sparkfunX/Qwiic_Spectral_Sensor-AS7341/Hardware/Qwiic_Spectral_Sensor_AS7341.pdf

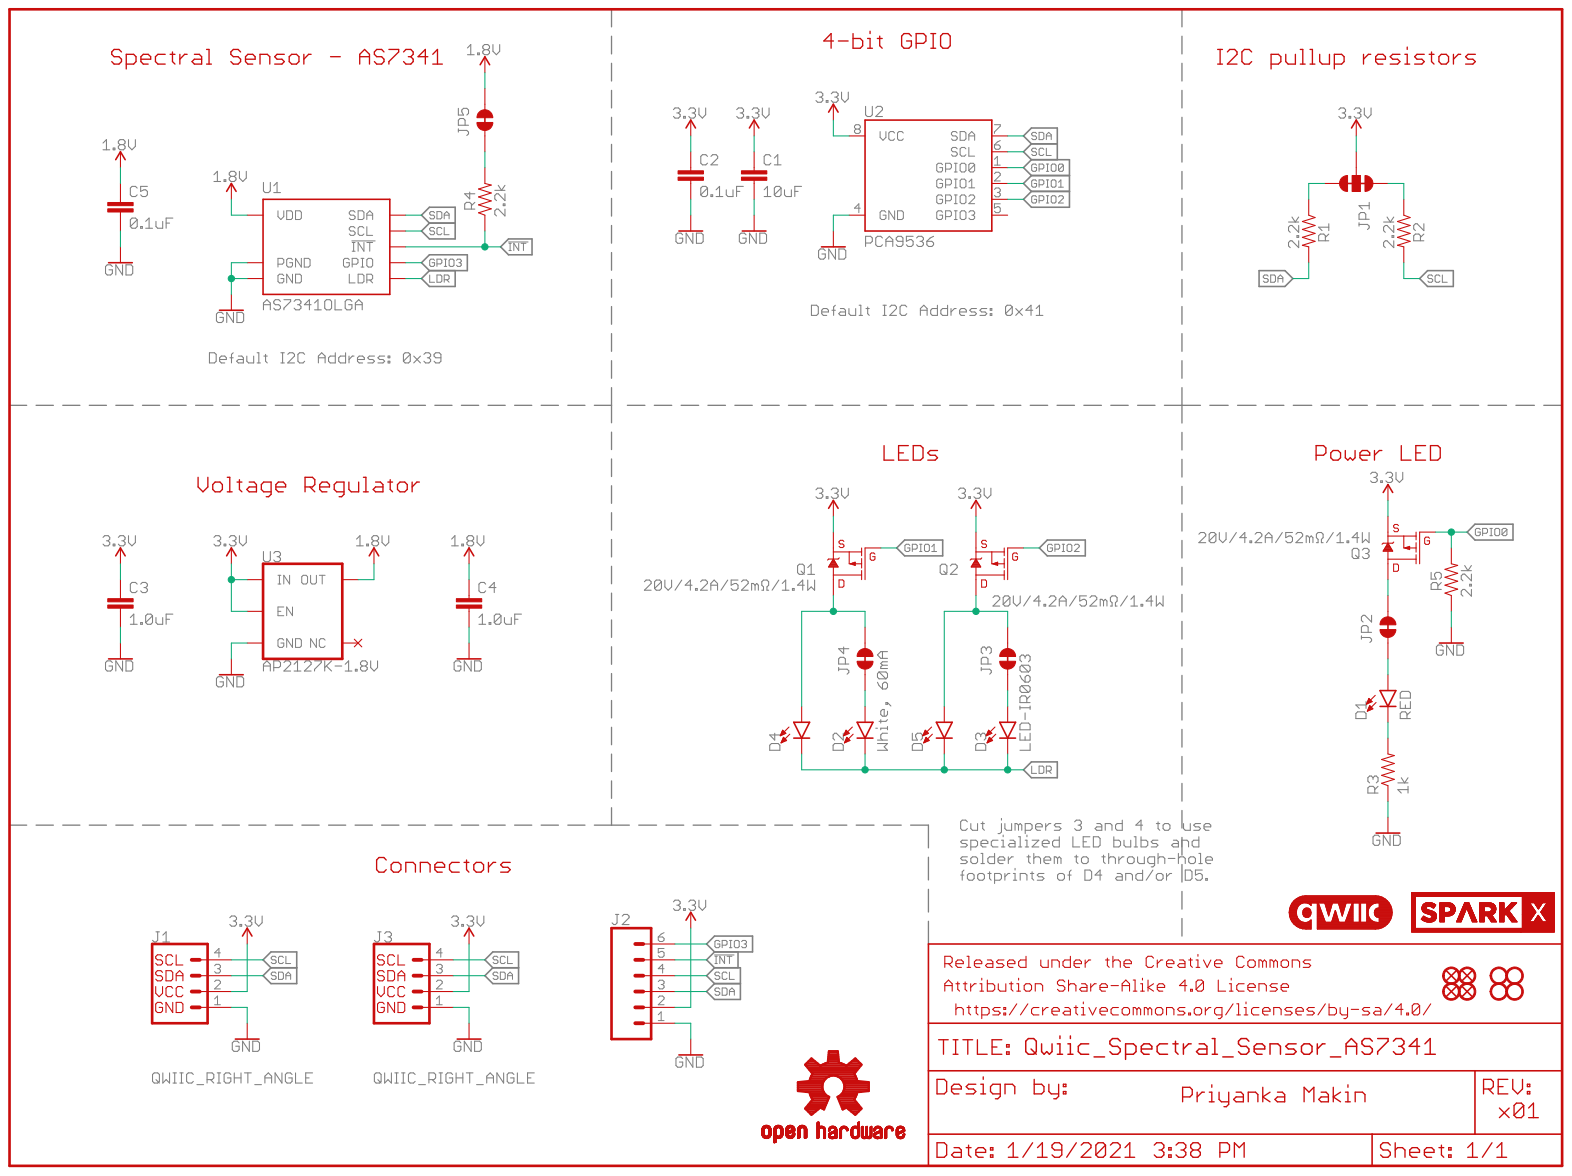
[picture p1: page 1]
