sparkfunX/Qwiic_Spectral_Sensor-AS7341/Hardware/Qwiic_Spectral_Sensor_AS7341.brd

## EAGLE design Hardware/Qwiic_Spectral_Sensor_AS7341.brd (2021-01-19)

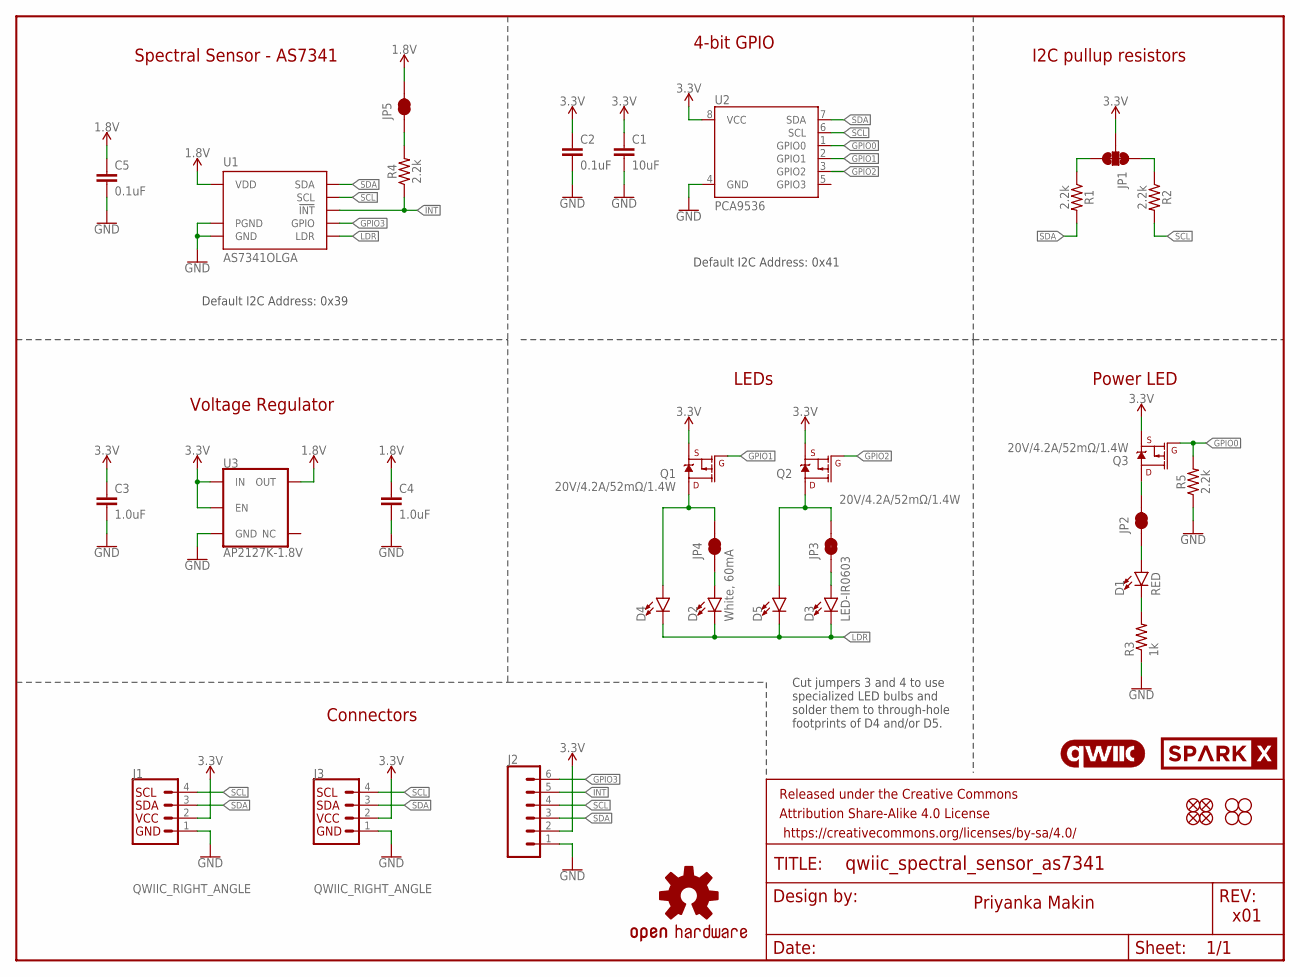
[picture p2: schematic Qwiic_Spectral_Sensor_AS7341.sch]

Parts:
C1: 10uF; 0603
C2, C5: 0.1uF; 0603
C3, C4: 1.0uF; 0603
D1: RED; LED-0603
D2: White, 60mA; SUPER_BRIGHT_SMD_LED_3014
D3: LED-IR0603; LED-0603
D4, D5: LED-3MM-NO_SILK; LED_3MM-NS
FD1, FD2, FD3, FD4: FIDUCIAL1X2; FIDUCIAL-1X2
FRAME1: FRAME-LETTER; CREATIVE_COMMONS
H1, H2, H3, H4: STAND-OFF
J1, J3: QWIIC_RIGHT_ANGLE; JST04_1MM_RA
J2: CONN_06NO_SILK_FEMALE_PTH; 1X06_NO_SILK
JP1: JUMPER-SMT_3_2-NC_TRACE_SILK; SMT-JUMPER_3_2-NC_TRACE_SILK
JP2, JP3, JP4, JP5: JUMPER-SMT_2_NC_TRACE_SILK; SMT-JUMPER_2_NC_TRACE_SILK
LOGO1: QWIIC_LOGO_6MM; QWIIC_6MM
Q1, Q2, Q3: 20V/4.2A/52mΩ/1.4W; SOT23-3
R1, R2, R4, R5: 2.2k; 0603
R3: 1k; 0603
U1: AS7341OLGA; OLGA8
U2: PCA9536; MSOP8
U3: AP2127K-1.8V; SOT23-5
U$1: OSHW-LOGOS; OSHW-LOGO-S
U$31: SPARKX-LOGO3; SPARKX-SMALL

Connections:
1.8V: C4.1, C5.1, JP5.2, U1.1 (VDD), U3.5 (OUT)
3.3V: C1.1, C2.1, C3.1, J1.2, J2.2, J3.2, JP1.2, Q1.2 (S), Q2.2 (S), Q3.2 (S), U2.8 (VCC), U3.1 (IN), U3.3 (EN)
!INT!: J2.5, R4.1, U1.7 (!INT!)
GND: C1.2, C2.2, C3.2, C4.2, C5.2, J1.1, J2.1, J3.1, R3.1, R5.1, U1.3 (GND), U1.5 (PGND), U2.4 (GND), U3.2 (GND)
GPIO0: Q3.1 (G), R5.2, U2.1 (GPIO0)
GPIO1: Q1.1 (G), U2.2 (GPIO1)
GPIO2: Q2.1 (G), U2.3 (GPIO2)
GPIO3: J2.6, U1.6 (GPIO)
LDR: D2.C, D3.C, D4.K (C), D5.K (C), U1.4 (LDR)
unnamed: JP1.3, R1.1
unnamed: D1.C, R3.2
unnamed: JP1.1, R2.1
unnamed: D1.A, JP2.1
unnamed: D2.A, JP4.1
unnamed: JP2.2, Q3.3 (D)
unnamed: D3.A, JP3.1
unnamed: D4.A, JP4.2, Q1.3 (D)
unnamed: D5.A, JP3.2, Q2.3 (D)
unnamed: JP5.1, R4.2
SCL: J1.4, J2.4, J3.4, R2.2, U1.2 (SCL), U2.6 (SCL)
SDA: J1.3, J2.3, J3.3, R1.2, U1.8 (SDA), U2.7 (SDA)

Notes on the sheet:
x01
Priyanka Makin
Connectors
Spectral Sensor - AS7341
4-bit GPIO
Power LED
Default I2C Address: 0x39
Default I2C Address: 0x41
I2C pullup resistors
Voltage Regulator
LEDs
Cut jumpers 3 and 4 to use specialized LED bulbs and solder them to through-hole footprints of D4 and/or D5.

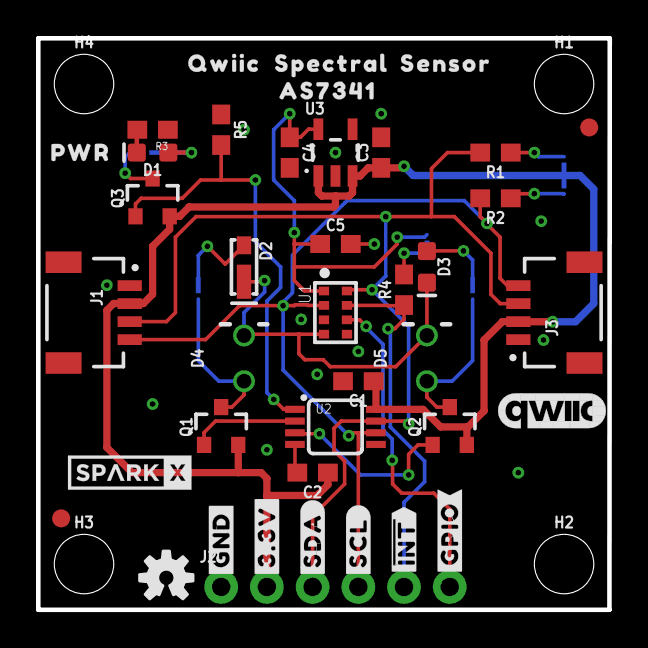
[picture p3: board Qwiic_Spectral_Sensor_AS7341.brd from above]

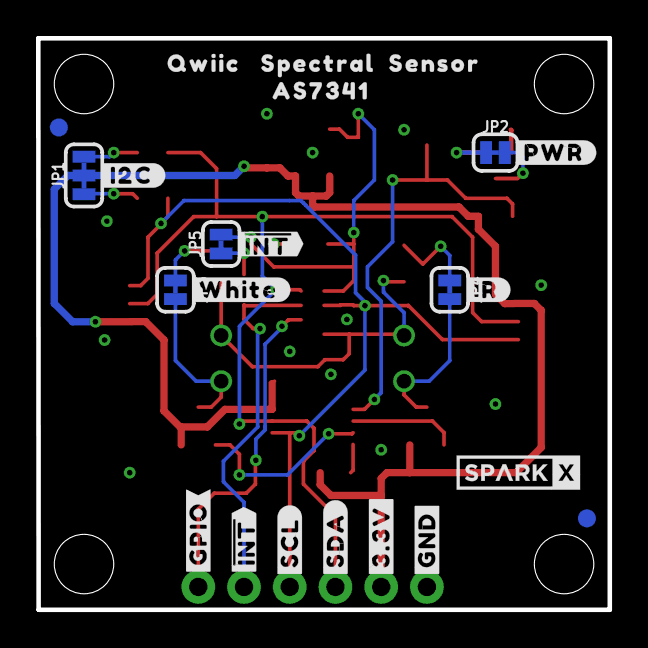
[picture p4: board Qwiic_Spectral_Sensor_AS7341.brd from below]

Board: 2 copper layers, 31.8 x 31.8 mm, 68 parts (23 on the bottom side), 21 nets.

Other parts of the board:
U$3, U$4: QWIIC0
U$5, U$8: SPECTRAL0
U$7: SPARKX-SMALL
U$9: #I2C#0
U$10: #PWR#0
U$11, U$21: SENSOR0
U$12: PWR0
U$13, U$14: #GND#0
U$15, U$16: #3#3V#0
U$17, U$18: #SDA#0
U$19, U$20: #SCL#0
U$22, U$23: AS73410
U$24, U$25, U$30: ##INT##0
U$26, U$27: #GPIO#0
U$28: #IR#0
U$29: #WHITE#0
