sparkfunX/Qwiic_Spectral_Sensor-AS7341/Hardware/Production/Qwiic_Spectral_Sensor_AS7341-Panel.brd

## EAGLE design Hardware/Production/Qwiic_Spectral_Sensor_AS7341-Panel.brd (2020-11-24)

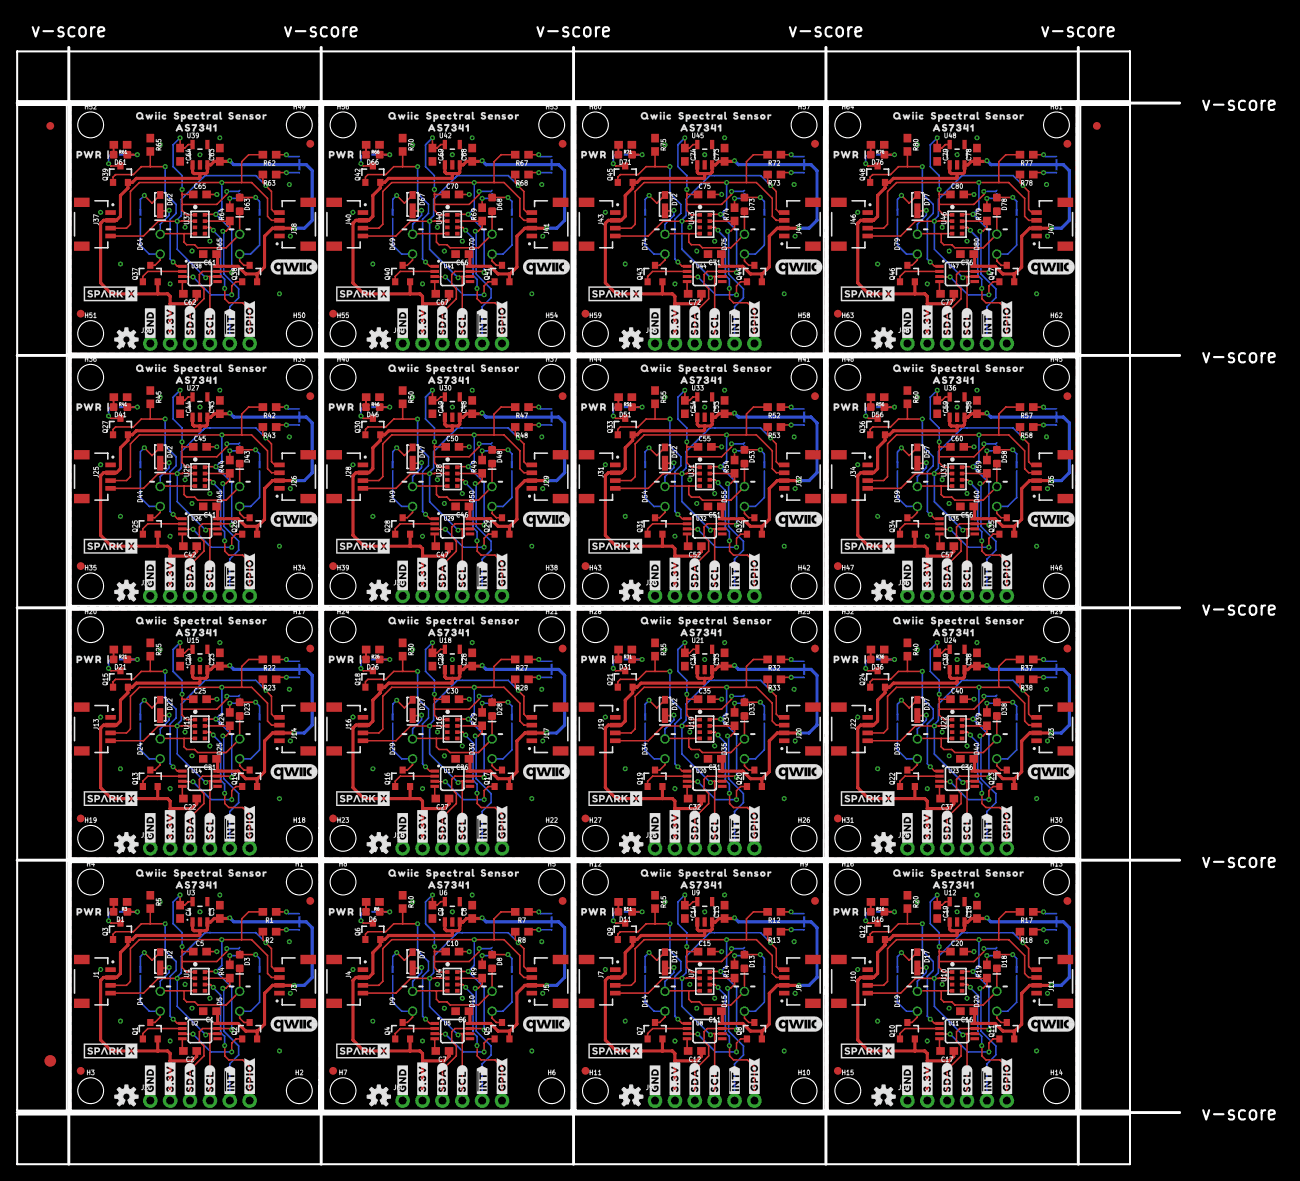
[picture p5: board Qwiic_Spectral_Sensor_AS7341-Panel.brd from above]

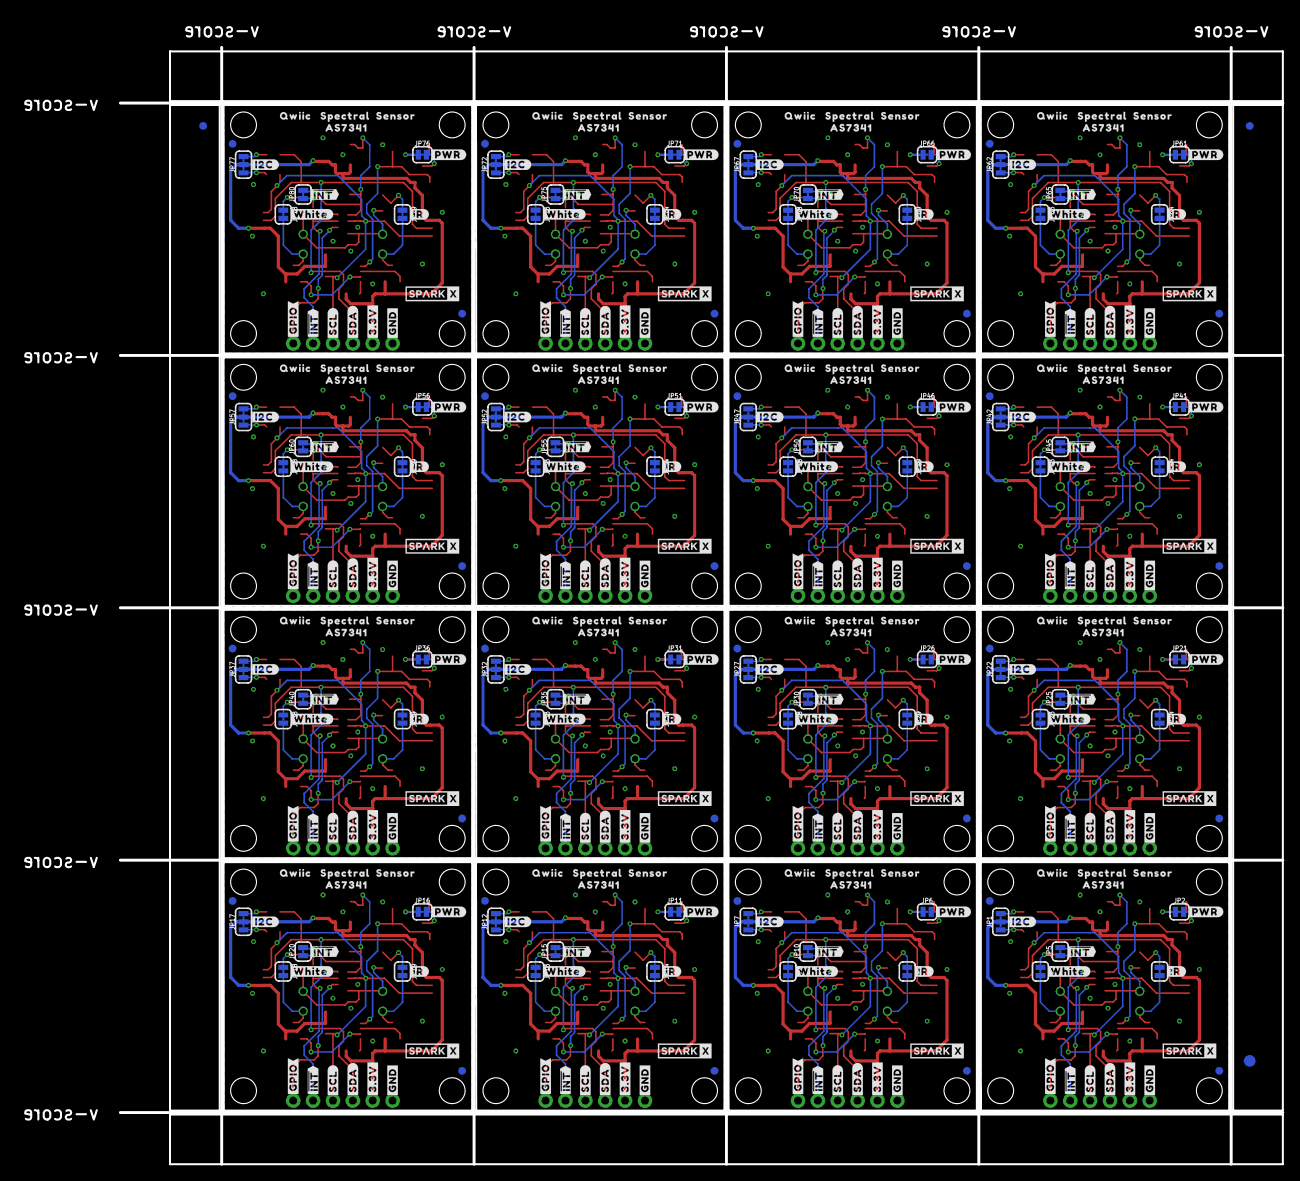
[picture p6: board Qwiic_Spectral_Sensor_AS7341-Panel.brd from below]

Board: 2 copper layers, 148.6 x 142.7 mm, 1078 parts (371 on the bottom side), 336 nets.

Parts:
C1, C6, C11, C16, C21, C26, C31, C36, C41, C46, C51, C56, C61, C66, C71, C76: 10uF; 0603
C2, C5, C7, C10, C12, C15, C17, C20, C22, C25, C27, C30, C32, C35, C37, C40, C42, C45, C47, C50, C52, C55, C57, C60, C62, C65, C67, C70, C72, C75, C77, C80: 0.1uF; 0603
C3, C4, C8, C9, C13, C14, C18, C19, C23, C24, C28, C29, C33, C34, C38, C39, C43, C44, C48, C49, C53, C54, C58, C59, C63, C64, C68, C69, C73, C74, C78, C79: 1.0uF; 0603
D1, D6, D11, D16, D21, D26, D31, D36, D41, D46, D51, D56, D61, D66, D71, D76: RED; LED-0603
D2, D7, D12, D17, D22, D27, D32, D37, D42, D47, D52, D57, D62, D67, D72, D77: White, 60mA; SUPER_BRIGHT_SMD_LED_3014
D3, D8, D13, D18, D23, D28, D33, D38, D43, D48, D53, D58, D63, D68, D73, D78: LED-IR0603; LED-0603
D4, D5, D9, D10, D14, D15, D19, D20, D24, D25, D29, D30, D34, D35, D39, D40, D44, D45, D49, D50, D54, D55, D59, D60, D64, D65, D69, D70, D74, D75, D79, D80: LED_3MM-NS
E$1, E$2, E$3, E$4: FIDUCIAL-1X2
E$5, E$6: FIDUCIAL-1.5X3
FD1, FD2, FD3, FD4, FD5, FD6, FD7, FD8, FD9, FD10, FD11, FD12, FD13, FD14, FD15, FD16, FD17, FD18, FD19, FD20, FD21, FD22, FD23, FD24, FD25, FD26, FD27, FD28, FD29, FD30, FD31, FD32, FD33, FD34, FD35, FD36, FD37, FD38, FD39, FD40, FD41, FD42, FD43, FD44, FD45, FD46, FD47, FD48, FD49, FD50, FD51, FD52, FD53, FD54, FD55, FD56, FD57, FD58, FD59, FD60, FD61, FD62, FD63, FD64: FIDUCIAL1X2; FIDUCIAL-1X2
H1, H2, H3, H4, H5, H6, H7, H8, H9, H10, H11, H12, H13, H14, H15, H16, H17, H18, H19, H20, H21, H22, H23, H24, H25, H26, H27, H28, H29, H30, H31, H32, H33, H34, H35, H36, H37, H38, H39, H40, H41, H42, H43, H44, H45, H46, H47, H48, H49, H50, H51, H52, H53, H54, H55, H56, H57, H58, H59, H60, H61, H62, H63, H64: STAND-OFF
J1, J3, J4, J5, J7, J8, J10, J11, J13, J14, J16, J17, J19, J20, J22, J23, J25, J26, J28, J29, J31, J32, J34, J35, J37, J38, J40, J41, J43, J44, J46, J47: QWIIC_RIGHT_ANGLE; JST04_1MM_RA
J2, J6, J9, J12, J15, J18, J21, J24, J27, J30, J33, J36, J39, J42, J45, J48: 1X06_NO_SILK
JP1, JP7, JP12, JP17, JP22, JP27, JP32, JP37, JP42, JP47, JP52, JP57, JP62, JP67, JP72, JP77: JUMPER-SMT_3_2-NC_TRACE_SILK; SMT-JUMPER_3_2-NC_TRACE_SILK
JP2, JP3, JP4, JP5, JP6, JP8, JP9, JP10, JP11, JP13, JP14, JP15, JP16, JP18, JP19, JP20, JP21, JP23, JP24, JP25, JP26, JP28, JP29, JP30, JP31, JP33, JP34, JP35, JP36, JP38, JP39, JP40, JP41, JP43, JP44, JP45, JP46, JP48, JP49, JP50, JP51, JP53, JP54, JP55, JP56, JP58, JP59, JP60, JP61, JP63, JP64, JP65, JP66, JP68, JP69, JP70, JP71, JP73, JP74, JP75, JP76, JP78, JP79, JP80: JUMPER-SMT_2_NC_TRACE_SILK; SMT-JUMPER_2_NC_TRACE_SILK
Q1, Q2, Q3, Q4, Q5, Q6, Q7, Q8, Q9, Q10, Q11, Q12, Q13, Q14, Q15, Q16, Q17, Q18, Q19, Q20, Q21, Q22, Q23, Q24, Q25, Q26, Q27, Q28, Q29, Q30, Q31, Q32, Q33, Q34, Q35, Q36, Q37, Q38, Q39, Q40, Q41, Q42, Q43, Q44, Q45, Q46, Q47, Q48: 20V/4.2A/52mΩ/1.4W; SOT23-3
R1, R2, R4, R5, R7, R8, R9, R10, R12, R13, R14, R15, R17, R18, R19, R20, R22, R23, R24, R25, R27, R28, R29, R30, R32, R33, R34, R35, R37, R38, R39, R40, R42, R43, R44, R45, R47, R48, R49, R50, R52, R53, R54, R55, R57, R58, R59, R60, R62, R63, R64, R65, R67, R68, R69, R70, R72, R73, R74, R75, R77, R78, R79, R80: 2.2k; 0603
R3, R6, R11, R16, R21, R26, R31, R36, R41, R46, R51, R56, R61, R66, R71, R76: 1k; 0603
U1, U4, U7, U10, U13, U16, U19, U22, U25, U28, U31, U34, U37, U40, U43, U46: AS7341OLGA; OLGA8
U2, U5, U8, U11, U14, U17, U20, U23, U26, U29, U32, U35, U38, U41, U44, U47: PCA9536; MSOP8
U3, U6, U9, U12, U15, U18, U21, U24, U27, U30, U33, U36, U39, U42, U45, U48: AP2127K-1.8V; SOT23-5
U$1, U$31, U$61, U$91, U$121, U$151, U$181, U$211, U$241, U$271, U$301, U$331, U$361, U$391, U$421, U$451: OSHW-LOGOS; OSHW-LOGO-S
U$2, U$32, U$62, U$92, U$122, U$152, U$182, U$212, U$242, U$272, U$302, U$332, U$362, U$392, U$422, U$452: QWIIC_6MM
U$3, U$4, U$46, U$47, U$76, U$77, U$106, U$107, U$136, U$137, U$166, U$167, U$196, U$197, U$226, U$227, U$256, U$257, U$286, U$287, U$316, U$317, U$346, U$347, U$376, U$377, U$406, U$407, U$436, U$437, U$466, U$467: QWIIC0
U$5, U$8, U$48, U$49, U$78, U$79, U$108, U$109, U$138, U$139, U$168, U$169, U$198, U$199, U$228, U$229, U$258, U$259, U$288, U$289, U$318, U$319, U$348, U$349, U$378, U$379, U$408, U$409, U$438, U$439, U$468, U$469: SPECTRAL0
U$6, U$7, U$44, U$45, U$74, U$75, U$104, U$105, U$134, U$135, U$164, U$165, U$194, U$195, U$224, U$225, U$254, U$255, U$284, U$285, U$314, U$315, U$344, U$345, U$374, U$375, U$404, U$405, U$434, U$435, U$464, U$465: SPARKX-SMALL
U$9, U$35, U$65, U$95, U$125, U$155, U$185, U$215, U$245, U$275, U$305, U$335, U$365, U$395, U$425, U$455: #I2C#0
U$10, U$34, U$64, U$94, U$124, U$154, U$184, U$214, U$244, U$274, U$304, U$334, U$364, U$394, U$424, U$454: #PWR#0
U$11, U$21, U$50, U$51, U$80, U$81, U$110, U$111, U$140, U$141, U$170, U$171, U$200, U$201, U$230, U$231, U$260, U$261, U$290, U$291, U$320, U$321, U$350, U$351, U$380, U$381, U$410, U$411, U$440, U$441, U$470, U$471: SENSOR0
U$12, U$33, U$63, U$93, U$123, U$153, U$183, U$213, U$243, U$273, U$303, U$333, U$363, U$393, U$423, U$453: PWR0
U$13, U$14, U$36, U$37, U$66, U$67, U$96, U$97, U$126, U$127, U$156, U$157, U$186, U$187, U$216, U$217, U$246, U$247, U$276, U$277, U$306, U$307, U$336, U$337, U$366, U$367, U$396, U$397, U$426, U$427, U$456, U$457: #GND#0
U$15, U$16, U$38, U$39, U$68, U$69, U$98, U$99, U$128, U$129, U$158, U$159, U$188, U$189, U$218, U$219, U$248, U$249, U$278, U$279, U$308, U$309, U$338, U$339, U$368, U$369, U$398, U$399, U$428, U$429, U$458, U$459: #3#3V#0
U$17, U$18, U$40, U$41, U$70, U$71, U$100, U$101, U$130, U$131, U$160, U$161, U$190, U$191, U$220, U$221, U$250, U$251, U$280, U$281, U$310, U$311, U$340, U$341, U$370, U$371, U$400, U$401, U$430, U$431, U$460, U$461: #SDA#0
U$19, U$20, U$42, U$43, U$72, U$73, U$102, U$103, U$132, U$133, U$162, U$163, U$192, U$193, U$222, U$223, U$252, U$253, U$282, U$283, U$312, U$313, U$342, U$343, U$372, U$373, U$402, U$403, U$432, U$433, U$462, U$463: #SCL#0
U$22, U$23, U$52, U$53, U$82, U$83, U$112, U$113, U$142, U$143, U$172, U$173, U$202, U$203, U$232, U$233, U$262, U$263, U$292, U$293, U$322, U$323, U$352, U$353, U$382, U$383, U$412, U$413, U$442, U$443, U$472, U$473: AS73410
U$24, U$25, U$30, U$56, U$57, U$58, U$86, U$87, U$88, U$116, U$117, U$118, U$146, U$147, U$148, U$176, U$177, U$178, U$206, U$207, U$208, U$236, U$237, U$238, U$266, U$267, U$268, U$296, U$297, U$298, U$326, U$327, U$328, U$356, U$357, U$358, U$386, U$387, U$388, U$416, U$417, U$418, U$446, U$447, U$448, U$476, U$477, U$478: ##INT##0
U$26, U$27, U$59, U$60, U$89, U$90, U$119, U$120, U$149, U$150, U$179, U$180, U$209, U$210, U$239, U$240, U$269, U$270, U$299, U$300, U$329, U$330, U$359, U$360, U$389, U$390, U$419, U$420, U$449, U$450, U$479, U$480: #GPIO#0
U$28, U$54, U$84, U$114, U$144, U$174, U$204, U$234, U$264, U$294, U$324, U$354, U$384, U$414, U$444, U$474: #IR#0
U$29, U$55, U$85, U$115, U$145, U$175, U$205, U$235, U$265, U$295, U$325, U$355, U$385, U$415, U$445, U$475: #WHITE#0

Connections:
1.8V: C4.1, C5.1, JP5.2, U1.1, U3.5
1.8V1: C9.1, C10.1, JP10.2, U4.1, U6.5
1.8V2: C14.1, C15.1, JP15.2, U7.1, U9.5
1.8V3: C19.1, C20.1, JP20.2, U10.1, U12.5
1.8V4: C24.1, C25.1, JP25.2, U13.1, U15.5
1.8V5: C29.1, C30.1, JP30.2, U16.1, U18.5
1.8V6: C34.1, C35.1, JP35.2, U19.1, U21.5
1.8V7: C39.1, C40.1, JP40.2, U22.1, U24.5
1.8V8: C44.1, C45.1, JP45.2, U25.1, U27.5
1.8V9: C49.1, C50.1, JP50.2, U28.1, U30.5
1.8V10: C54.1, C55.1, JP55.2, U31.1, U33.5
1.8V11: C59.1, C60.1, JP60.2, U34.1, U36.5
1.8V12: C64.1, C65.1, JP65.2, U37.1, U39.5
1.8V13: C69.1, C70.1, JP70.2, U40.1, U42.5
1.8V14: C74.1, C75.1, JP75.2, U43.1, U45.5
1.8V15: C79.1, C80.1, JP80.2, U46.1, U48.5
3.3V: C1.1, C2.1, C3.1, J1.2, J2.2, J3.2, JP1.2, Q1.2, Q2.2, Q3.2, U2.8, U3.1, U3.3
3.3V1: C6.1, C7.1, C8.1, J4.2, J5.2, J6.2, JP7.2, Q4.2, Q5.2, Q6.2, U5.8, U6.1, U6.3
3.3V2: C11.1, C12.1, C13.1, J7.2, J8.2, J9.2, JP12.2, Q7.2, Q8.2, Q9.2, U8.8, U9.1, U9.3
3.3V3: C16.1, C17.1, C18.1, J10.2, J11.2, J12.2, JP17.2, Q10.2, Q11.2, Q12.2, U11.8, U12.1, U12.3
3.3V4: C21.1, C22.1, C23.1, J13.2, J14.2, J15.2, JP22.2, Q13.2, Q14.2, Q15.2, U14.8, U15.1, U15.3
3.3V5: C26.1, C27.1, C28.1, J16.2, J17.2, J18.2, JP27.2, Q16.2, Q17.2, Q18.2, U17.8, U18.1, U18.3
3.3V6: C31.1, C32.1, C33.1, J19.2, J20.2, J21.2, JP32.2, Q19.2, Q20.2, Q21.2, U20.8, U21.1, U21.3
3.3V7: C36.1, C37.1, C38.1, J22.2, J23.2, J24.2, JP37.2, Q22.2, Q23.2, Q24.2, U23.8, U24.1, U24.3
3.3V8: C41.1, C42.1, C43.1, J25.2, J26.2, J27.2, JP42.2, Q25.2, Q26.2, Q27.2, U26.8, U27.1, U27.3
3.3V9: C46.1, C47.1, C48.1, J28.2, J29.2, J30.2, JP47.2, Q28.2, Q29.2, Q30.2, U29.8, U30.1, U30.3
3.3V10: C51.1, C52.1, C53.1, J31.2, J32.2, J33.2, JP52.2, Q31.2, Q32.2, Q33.2, U32.8, U33.1, U33.3
3.3V11: C56.1, C57.1, C58.1, J34.2, J35.2, J36.2, JP57.2, Q34.2, Q35.2, Q36.2, U35.8, U36.1, U36.3
3.3V12: C61.1, C62.1, C63.1, J37.2, J38.2, J39.2, JP62.2, Q37.2, Q38.2, Q39.2, U38.8, U39.1, U39.3
3.3V13: C66.1, C67.1, C68.1, J40.2, J41.2, J42.2, JP67.2, Q40.2, Q41.2, Q42.2, U41.8, U42.1, U42.3
3.3V14: C71.1, C72.1, C73.1, J43.2, J44.2, J45.2, JP72.2, Q43.2, Q44.2, Q45.2, U44.8, U45.1, U45.3
3.3V15: C76.1, C77.1, C78.1, J46.2, J47.2, J48.2, JP77.2, Q46.2, Q47.2, Q48.2, U47.8, U48.1, U48.3
!INT!: J2.5, R4.1, U1.7
!INT!1: J6.5, R9.1, U4.7
!INT!2: J9.5, R14.1, U7.7
!INT!3: J12.5, R19.1, U10.7
!INT!4: J15.5, R24.1, U13.7
!INT!5: J18.5, R29.1, U16.7
!INT!6: J21.5, R34.1, U19.7
!INT!7: J24.5, R39.1, U22.7
!INT!8: J27.5, R44.1, U25.7
!INT!9: J30.5, R49.1, U28.7
!INT!10: J33.5, R54.1, U31.7
!INT!11: J36.5, R59.1, U34.7
!INT!12: J39.5, R64.1, U37.7
!INT!13: J42.5, R69.1, U40.7
!INT!14: J45.5, R74.1, U43.7
!INT!15: J48.5, R79.1, U46.7
GND: C1.2, C2.2, C3.2, C4.2, C5.2, J1.1, J2.1, J3.1, R3.1, R5.1, U1.3, U1.5, U2.4, U3.2
GND1: C6.2, C7.2, C8.2, C9.2, C10.2, J4.1, J5.1, J6.1, R6.1, R10.1, U4.3, U4.5, U5.4, U6.2
GND2: C11.2, C12.2, C13.2, C14.2, C15.2, J7.1, J8.1, J9.1, R11.1, R15.1, U7.3, U7.5, U8.4, U9.2
GND3: C16.2, C17.2, C18.2, C19.2, C20.2, J10.1, J11.1, J12.1, R16.1, R20.1, U10.3, U10.5, U11.4, U12.2
GND4: C21.2, C22.2, C23.2, C24.2, C25.2, J13.1, J14.1, J15.1, R21.1, R25.1, U13.3, U13.5, U14.4, U15.2
GND5: C26.2, C27.2, C28.2, C29.2, C30.2, J16.1, J17.1, J18.1, R26.1, R30.1, U16.3, U16.5, U17.4, U18.2
GND6: C31.2, C32.2, C33.2, C34.2, C35.2, J19.1, J20.1, J21.1, R31.1, R35.1, U19.3, U19.5, U20.4, U21.2
GND7: C36.2, C37.2, C38.2, C39.2, C40.2, J22.1, J23.1, J24.1, R36.1, R40.1, U22.3, U22.5, U23.4, U24.2
GND8: C41.2, C42.2, C43.2, C44.2, C45.2, J25.1, J26.1, J27.1, R41.1, R45.1, U25.3, U25.5, U26.4, U27.2
GND9: C46.2, C47.2, C48.2, C49.2, C50.2, J28.1, J29.1, J30.1, R46.1, R50.1, U28.3, U28.5, U29.4, U30.2
GND10: C51.2, C52.2, C53.2, C54.2, C55.2, J31.1, J32.1, J33.1, R51.1, R55.1, U31.3, U31.5, U32.4, U33.2
GND11: C56.2, C57.2, C58.2, C59.2, C60.2, J34.1, J35.1, J36.1, R56.1, R60.1, U34.3, U34.5, U35.4, U36.2
GND12: C61.2, C62.2, C63.2, C64.2, C65.2, J37.1, J38.1, J39.1, R61.1, R65.1, U37.3, U37.5, U38.4, U39.2
GND13: C66.2, C67.2, C68.2, C69.2, C70.2, J40.1, J41.1, J42.1, R66.1, R70.1, U40.3, U40.5, U41.4, U42.2
GND14: C71.2, C72.2, C73.2, C74.2, C75.2, J43.1, J44.1, J45.1, R71.1, R75.1, U43.3, U43.5, U44.4, U45.2
GND15: C76.2, C77.2, C78.2, C79.2, C80.2, J46.1, J47.1, J48.1, R76.1, R80.1, U46.3, U46.5, U47.4, U48.2
GPIO0: Q3.1, R5.2, U2.1
GPIO1: Q1.1, U2.2
GPIO2: Q2.1, U2.3
GPIO3: J2.6, U1.6
GPIO4: Q6.1, R10.2, U5.1
GPIO5: Q4.1, U5.2
GPIO6: Q5.1, U5.3
GPIO7: J6.6, U4.6
GPIO8: Q9.1, R15.2, U8.1
GPIO9: Q7.1, U8.2
GPIO10: Q8.1, U8.3
GPIO11: J9.6, U7.6
GPIO12: Q12.1, R20.2, U11.1
GPIO13: Q10.1, U11.2
GPIO14: Q11.1, U11.3
GPIO15: J12.6, U10.6
GPIO16: Q15.1, R25.2, U14.1
GPIO17: Q13.1, U14.2
GPIO18: Q14.1, U14.3
GPIO19: J15.6, U13.6
GPIO20: Q18.1, R30.2, U17.1
GPIO21: Q16.1, U17.2
GPIO22: Q17.1, U17.3
GPIO23: J18.6, U16.6
GPIO24: Q21.1, R35.2, U20.1
GPIO25: Q19.1, U20.2
GPIO26: Q20.1, U20.3
GPIO27: J21.6, U19.6
GPIO28: Q24.1, R40.2, U23.1
GPIO29: Q22.1, U23.2
GPIO30: Q23.1, U23.3
GPIO31: J24.6, U22.6
GPIO32: Q27.1, R45.2, U26.1
GPIO33: Q25.1, U26.2
GPIO34: Q26.1, U26.3
GPIO35: J27.6, U25.6
GPIO36: Q30.1, R50.2, U29.1
GPIO37: Q28.1, U29.2
GPIO38: Q29.1, U29.3
GPIO39: J30.6, U28.6
GPIO40: Q33.1, R55.2, U32.1
GPIO41: Q31.1, U32.2
GPIO42: Q32.1, U32.3
GPIO43: J33.6, U31.6
GPIO44: Q36.1, R60.2, U35.1
GPIO45: Q34.1, U35.2
GPIO46: Q35.1, U35.3
GPIO47: J36.6, U34.6
GPIO48: Q39.1, R65.2, U38.1
GPIO49: Q37.1, U38.2
GPIO50: Q38.1, U38.3
GPIO51: J39.6, U37.6
GPIO52: Q42.1, R70.2, U41.1
GPIO53: Q40.1, U41.2
GPIO54: Q41.1, U41.3
GPIO55: J42.6, U40.6
GPIO56: Q45.1, R75.2, U44.1
GPIO57: Q43.1, U44.2
GPIO58: Q44.1, U44.3
GPIO59: J45.6, U43.6
GPIO60: Q48.1, R80.2, U47.1
GPIO61: Q46.1, U47.2
GPIO62: Q47.1, U47.3
GPIO63: J48.6, U46.6
LDR: D2.C, D3.C, D4.K, D5.K, U1.4
LDR1: D7.C, D8.C, D9.K, D10.K, U4.4
LDR2: D12.C, D13.C, D14.K, D15.K, U7.4
LDR3: D17.C, D18.C, D19.K, D20.K, U10.4
LDR4: D22.C, D23.C, D24.K, D25.K, U13.4
LDR5: D27.C, D28.C, D29.K, D30.K, U16.4
LDR6: D32.C, D33.C, D34.K, D35.K, U19.4
LDR7: D37.C, D38.C, D39.K, D40.K, U22.4
LDR8: D42.C, D43.C, D44.K, D45.K, U25.4
LDR9: D47.C, D48.C, D49.K, D50.K, U28.4
LDR10: D52.C, D53.C, D54.K, D55.K, U31.4
LDR11: D57.C, D58.C, D59.K, D60.K, U34.4
LDR12: D62.C, D63.C, D64.K, D65.K, U37.4
LDR13: D67.C, D68.C, D69.K, D70.K, U40.4
LDR14: D72.C, D73.C, D74.K, D75.K, U43.4
LDR15: D77.C, D78.C, D79.K, D80.K, U46.4
unnamed: JP1.3, R1.1
unnamed: D1.C, R3.2
unnamed: JP1.1, R2.1
unnamed: D1.A, JP2.1
unnamed: D2.A, JP4.1
unnamed: JP2.2, Q3.3
unnamed: D3.A, JP3.1
unnamed: D4.A, JP4.2, Q1.3
unnamed: D5.A, JP3.2, Q2.3
unnamed: JP5.1, R4.2
unnamed: D6.C, R6.2
unnamed: D6.A, JP6.1
unnamed: JP7.3, R7.1
unnamed: JP7.1, R8.1
unnamed: D7.A, JP9.1
unnamed: D8.A, JP8.1
unnamed: D9.A, JP9.2, Q4.3
unnamed: D10.A, JP8.2, Q5.3
unnamed: JP6.2, Q6.3
unnamed: JP10.1, R9.2
unnamed: D11.C, R11.2
unnamed: D11.A, JP11.1
unnamed: JP12.3, R12.1
unnamed: JP12.1, R13.1
unnamed: D12.A, JP14.1
unnamed: D13.A, JP13.1
unnamed: D14.A, JP14.2, Q7.3
unnamed: D15.A, JP13.2, Q8.3
unnamed: JP11.2, Q9.3
unnamed: JP15.1, R14.2
unnamed: D16.C, R16.2
unnamed: D16.A, JP16.1
unnamed: JP17.3, R17.1
unnamed: JP17.1, R18.1
unnamed: D17.A, JP19.1
unnamed: D18.A, JP18.1
unnamed: D19.A, JP19.2, Q10.3
unnamed: D20.A, JP18.2, Q11.3
unnamed: JP16.2, Q12.3
unnamed: JP20.1, R19.2
unnamed: D21.C, R21.2
unnamed: D21.A, JP21.1
unnamed: JP22.3, R22.1
unnamed: JP22.1, R23.1
unnamed: D22.A, JP24.1
unnamed: D23.A, JP23.1
unnamed: D24.A, JP24.2, Q13.3
unnamed: D25.A, JP23.2, Q14.3
unnamed: JP21.2, Q15.3
unnamed: JP25.1, R24.2
unnamed: D26.C, R26.2
unnamed: D26.A, JP26.1
unnamed: JP27.3, R27.1
unnamed: JP27.1, R28.1
unnamed: D27.A, JP29.1
unnamed: D28.A, JP28.1
unnamed: D29.A, JP29.2, Q16.3
unnamed: D30.A, JP28.2, Q17.3
unnamed: JP26.2, Q18.3
unnamed: JP30.1, R29.2
unnamed: D31.C, R31.2
unnamed: D31.A, JP31.1
unnamed: JP32.3, R32.1
unnamed: JP32.1, R33.1
unnamed: D32.A, JP34.1
unnamed: D33.A, JP33.1
unnamed: D34.A, JP34.2, Q19.3
unnamed: D35.A, JP33.2, Q20.3
unnamed: JP31.2, Q21.3
unnamed: JP35.1, R34.2
unnamed: D36.C, R36.2
unnamed: D36.A, JP36.1
unnamed: JP37.3, R37.1
unnamed: JP37.1, R38.1
unnamed: D37.A, JP39.1
unnamed: D38.A, JP38.1
unnamed: D39.A, JP39.2, Q22.3
unnamed: D40.A, JP38.2, Q23.3
unnamed: JP36.2, Q24.3
unnamed: JP40.1, R39.2
unnamed: D41.C, R41.2
unnamed: D41.A, JP41.1
unnamed: JP42.3, R42.1
unnamed: JP42.1, R43.1
unnamed: D42.A, JP44.1
unnamed: D43.A, JP43.1
unnamed: D44.A, JP44.2, Q25.3
unnamed: D45.A, JP43.2, Q26.3
unnamed: JP41.2, Q27.3
unnamed: JP45.1, R44.2
unnamed: D46.C, R46.2
unnamed: D46.A, JP46.1
unnamed: JP47.3, R47.1
unnamed: JP47.1, R48.1
unnamed: D47.A, JP49.1
unnamed: D48.A, JP48.1
unnamed: D49.A, JP49.2, Q28.3
unnamed: D50.A, JP48.2, Q29.3
unnamed: JP46.2, Q30.3
unnamed: JP50.1, R49.2
unnamed: D51.C, R51.2
unnamed: D51.A, JP51.1
unnamed: JP52.3, R52.1
unnamed: JP52.1, R53.1
unnamed: D52.A, JP54.1
unnamed: D53.A, JP53.1
unnamed: D54.A, JP54.2, Q31.3
unnamed: D55.A, JP53.2, Q32.3
unnamed: JP51.2, Q33.3
unnamed: JP55.1, R54.2
unnamed: D56.C, R56.2
unnamed: D56.A, JP56.1
unnamed: JP57.3, R57.1
unnamed: JP57.1, R58.1
unnamed: D57.A, JP59.1
unnamed: D58.A, JP58.1
unnamed: D59.A, JP59.2, Q34.3
unnamed: D60.A, JP58.2, Q35.3
unnamed: JP56.2, Q36.3
unnamed: JP60.1, R59.2
unnamed: D61.C, R61.2
unnamed: D61.A, JP61.1
unnamed: JP62.3, R62.1
unnamed: JP62.1, R63.1
unnamed: D62.A, JP64.1
unnamed: D63.A, JP63.1
unnamed: D64.A, JP64.2, Q37.3
unnamed: D65.A, JP63.2, Q38.3
unnamed: JP61.2, Q39.3
unnamed: JP65.1, R64.2
unnamed: D66.C, R66.2
unnamed: D66.A, JP66.1
unnamed: JP67.3, R67.1
unnamed: JP67.1, R68.1
unnamed: D67.A, JP69.1
unnamed: D68.A, JP68.1
unnamed: D69.A, JP69.2, Q40.3
unnamed: D70.A, JP68.2, Q41.3
unnamed: JP66.2, Q42.3
unnamed: JP70.1, R69.2
unnamed: D71.C, R71.2
unnamed: D71.A, JP71.1
unnamed: JP72.3, R72.1
unnamed: JP72.1, R73.1
unnamed: D72.A, JP74.1
unnamed: D73.A, JP73.1
unnamed: D74.A, JP74.2, Q43.3
unnamed: D75.A, JP73.2, Q44.3
unnamed: JP71.2, Q45.3
unnamed: JP75.1, R74.2
unnamed: D76.C, R76.2
unnamed: D76.A, JP76.1
unnamed: JP77.3, R77.1
unnamed: JP77.1, R78.1
unnamed: D77.A, JP79.1
unnamed: D78.A, JP78.1
unnamed: D79.A, JP79.2, Q46.3
unnamed: D80.A, JP78.2, Q47.3
unnamed: JP76.2, Q48.3
unnamed: JP80.1, R79.2
SCL: J1.4, J2.4, J3.4, R2.2, U1.2, U2.6
SCL1: J4.4, J5.4, J6.4, R8.2, U4.2, U5.6
SCL2: J7.4, J8.4, J9.4, R13.2, U7.2, U8.6
SCL3: J10.4, J11.4, J12.4, R18.2, U10.2, U11.6
SCL4: J13.4, J14.4, J15.4, R23.2, U13.2, U14.6
SCL5: J16.4, J17.4, J18.4, R28.2, U16.2, U17.6
SCL6: J19.4, J20.4, J21.4, R33.2, U19.2, U20.6
SCL7: J22.4, J23.4, J24.4, R38.2, U22.2, U23.6
SCL8: J25.4, J26.4, J27.4, R43.2, U25.2, U26.6
SCL9: J28.4, J29.4, J30.4, R48.2, U28.2, U29.6
SCL10: J31.4, J32.4, J33.4, R53.2, U31.2, U32.6
SCL11: J34.4, J35.4, J36.4, R58.2, U34.2, U35.6
SCL12: J37.4, J38.4, J39.4, R63.2, U37.2, U38.6
SCL13: J40.4, J41.4, J42.4, R68.2, U40.2, U41.6
SCL14: J43.4, J44.4, J45.4, R73.2, U43.2, U44.6
SCL15: J46.4, J47.4, J48.4, R78.2, U46.2, U47.6
SDA: J1.3, J2.3, J3.3, R1.2, U1.8, U2.7
SDA1: J4.3, J5.3, J6.3, R7.2, U4.8, U5.7
SDA2: J7.3, J8.3, J9.3, R12.2, U7.8, U8.7
SDA3: J10.3, J11.3, J12.3, R17.2, U10.8, U11.7
SDA4: J13.3, J14.3, J15.3, R22.2, U13.8, U14.7
SDA5: J16.3, J17.3, J18.3, R27.2, U16.8, U17.7
SDA6: J19.3, J20.3, J21.3, R32.2, U19.8, U20.7
SDA7: J22.3, J23.3, J24.3, R37.2, U22.8, U23.7
SDA8: J25.3, J26.3, J27.3, R42.2, U25.8, U26.7
SDA9: J28.3, J29.3, J30.3, R47.2, U28.8, U29.7
SDA10: J31.3, J32.3, J33.3, R52.2, U31.8, U32.7
SDA11: J34.3, J35.3, J36.3, R57.2, U34.8, U35.7
SDA12: J37.3, J38.3, J39.3, R62.2, U37.8, U38.7
SDA13: J40.3, J41.3, J42.3, R67.2, U40.8, U41.7
SDA14: J43.3, J44.3, J45.3, R72.2, U43.8, U44.7
SDA15: J46.3, J47.3, J48.3, R77.2, U46.8, U47.7
