sparkfunX/Qwiic_Spectral_Sensor-AS7341/Hardware/Production/ordering_instructions.txt

panel size, 143x143mm
PCB thickness, 1.6mm
number of layers, 2
soldermask color, Black
silkscreen color, White
oz copper, 1oz
finish, HASL lead free
stencils, top
pcs per panel, 16
min trace width, 0.2032mm / 0.0080in
min drill size, 0.3048mm / 0.0120in
