sparkfunX/Qwiic_Spectral_Sensor-AS7341/(commit log)

2020-11-19 Initial commit
    Getting files in place
    [Qwiic_Spectral_Sensor_AS7341L.brd, Qwiic_Spectral_Sensor_AS7341L.sch]
2020-11-19 Rename files. Actually using the AS7341
    [Qwiic_Spectral_Sensor_AS7341.brd, Qwiic_Spectral_Sensor_AS7341.sch]
2020-11-19 Working on schematic
    [Qwiic_Spectral_Sensor_AS7341.brd, Qwiic_Spectral_Sensor_AS7341.sch]
2020-11-20 First draft of schematic finished
    [Qwiic_Spectral_Sensor_AS7341.brd, Qwiic_Spectral_Sensor_AS7341.sch]
2020-11-20 Added int pin to schematic
    [Qwiic_Spectral_Sensor_AS7341.brd, Qwiic_Spectral_Sensor_AS7341.sch]
2020-11-20 added as7341 decoupling cap
    [Qwiic_Spectral_Sensor_AS7341.brd, Qwiic_Spectral_Sensor_AS7341.sch]
2020-11-23 Board design
    [Qwiic_Spectral_Sensor_AS7341.brd, Qwiic_Spectral_Sensor_AS7341.sch]
2020-11-23 Buzzard labels
    [Qwiic_Spectral_Sensor_AS7341.brd]
2020-11-24 Board review notes
    [Qwiic_Spectral_Sensor_AS7341.brd, Qwiic_Spectral_Sensor_AS7341.sch]
2021-01-19 Add schematic.
    [Qwiic_Spectral_Sensor_AS7341.brd, Qwiic_Spectral_Sensor_AS7341.sch]
2021-03-17 Added GPIO and interrupt sketches and library functions.
2021-03-21 Added Single channel measurement; fixed readAllChannel function; updated project per Nathan's suggestions
    [Example1-Raw_Measurement.ino, Example2-Basic_Count_Measurement.ino, Example3-LED_Control.ino, Example4-Interrupt.ino, Example5-GPIO_Input.ino, Example6-GPIO_Output.ino, Example7-Single_Channel_Measurement.ino, SparFun_AS7341L_IO.cpp]
2021-03-22 Added Threshold Interrupt and Register Read/Write examples and corresponding library functions.
